kedestin/Junior-Design/Phase 5/pinout.md

# Pin-Outs (Untaped Bot)

## Dashboard

### Seven-Segment

             _______
          F_|        |_A
          G_|        |_B
    cathode_|        |_cathode
            |        |
          E_|        |_DP
          D_|        |_C
            |________|

* f - 51
* g - 50
* e - 49
* d - 47
* a - 53
* b - 52
* dp - No connection
* c - 34

### Misc. Leds

* Red LED - 48
* Green LED - 46
* Blue LED - 44
* Yellow LED - 2

### Horn

* Speaker - 3

## Receiver

* Mic Input - A7

## Transmitter

* PWM Out - 5
* Data Out - 30

## H-Bridge

* Left Rear - 8
* Left Forward - 10
* Right Rear - 11
* Right Forward - 9

## Sensor Board

### Color Sensor

* Red LED - 36
* Blue LED - 37
* Photodiode - A15

### Proximity Sensor

* Photodiode - A5

### Hall Sensor

* Output - 39

## Indicator Lights

### Front-Left

* White LED - 45

### Front-Right

* White LED - 38

### Back-Left

* Red LED - 25
* Yellow LED - 27

### Back-Right

* Red LED - 24
* Yellow LED - 26

## Bumpers 

### Front-Left 

* Limit Switch - 43

### Front-Right

* Limit Switch - 42

### Back

* Limit Switch - 28

## Bot 1 vs. Bot 2

* Signal - 33
