kedestin/Junior-Design/Erythraean/Status Report Slides.pptx

## Week One Status

- Completed Pre Studio 1A
- Working on Design
- Need Pre Studio 1B and Design 1B done for Thursday, then onto 2.
- Team building – yay!

## Week Two Status Report

- Completed Phase 1A on Thursday 1/24
- Completed Phase 1B on Saturday 1/26
- We are on track with our schedule
- Phase 2A to be started in Monday meeting
- Target Demo Date for 2A TBD
- Teamwork is good so far
- Everything is taking longer than expected - we’re doing too much or we’re underestimating?

## Week Three Status Report

- Completed Phase 2A even with delay (Kelsey sick)
- Began work on Phase 2B.
- Burned ~5 MoSfEtS
- Have a functional MOSFET H-Bridge
- Teamwork and communication good (Kelsey upset with this description – how’s that for teamwork and communication huh)
- Ron, if you’re reading this, blink twice.
- Gotcha.

## Week Four Status Report

- Completed Phase 2B on Tuesday
- Began work on Phase 3A on Thursday
- Next week continuing work on 3A, will decide due date soon
- Have a small fixture to test photodiode – more work required
- Code for sensing needs to be done
- Integrating motion and sensors potentially by end of week

## Week Five Status Report

- Everything for Design 3A is complete
- Demo’ing on Tuesday (2/19)
- Collision Detection Spec will be started next week
- 2/14 Talked to Client/Contractor about phase 3B
- Team Morale still high
- Crushing it.

## Week Six Status Report

- Demo’d Design 3A on Tuesday 2/19
- Worked on Collision Detection Spec to give to Team Corbeau 2/21
- Have final document to hand to Corbeau
- Signed Griege spec 2/19
- Worked on improving color detection and searching
- Started futzing with limit switches – have working circuit
- Team morale: still good.
- Still crushing it.
