kedestin/Junior-Design/Erythraean/BatMobile_2B.jpeg

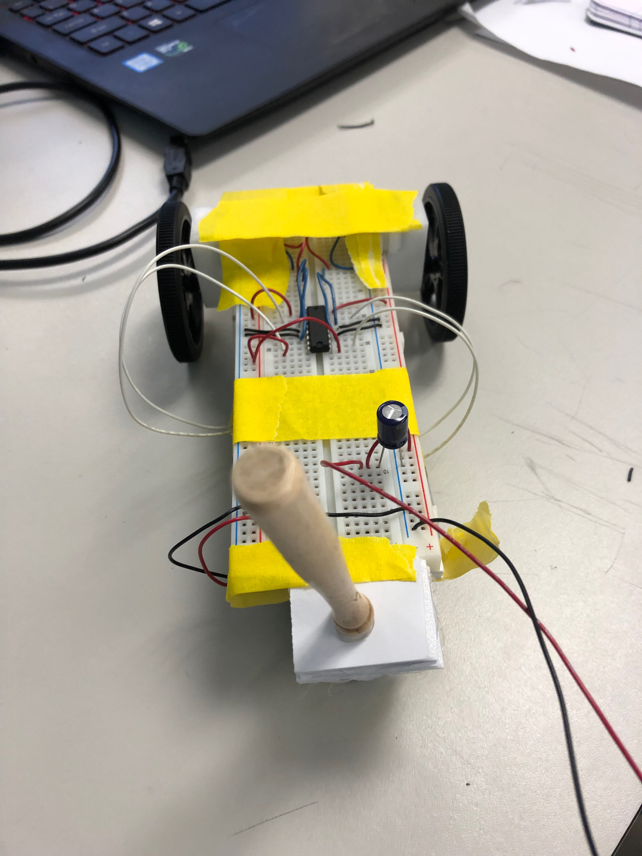
Erythraean/BatMobile_2B.jpeg
