kedestin/Junior-Design/Erythraean/Circuit_01A.jpeg

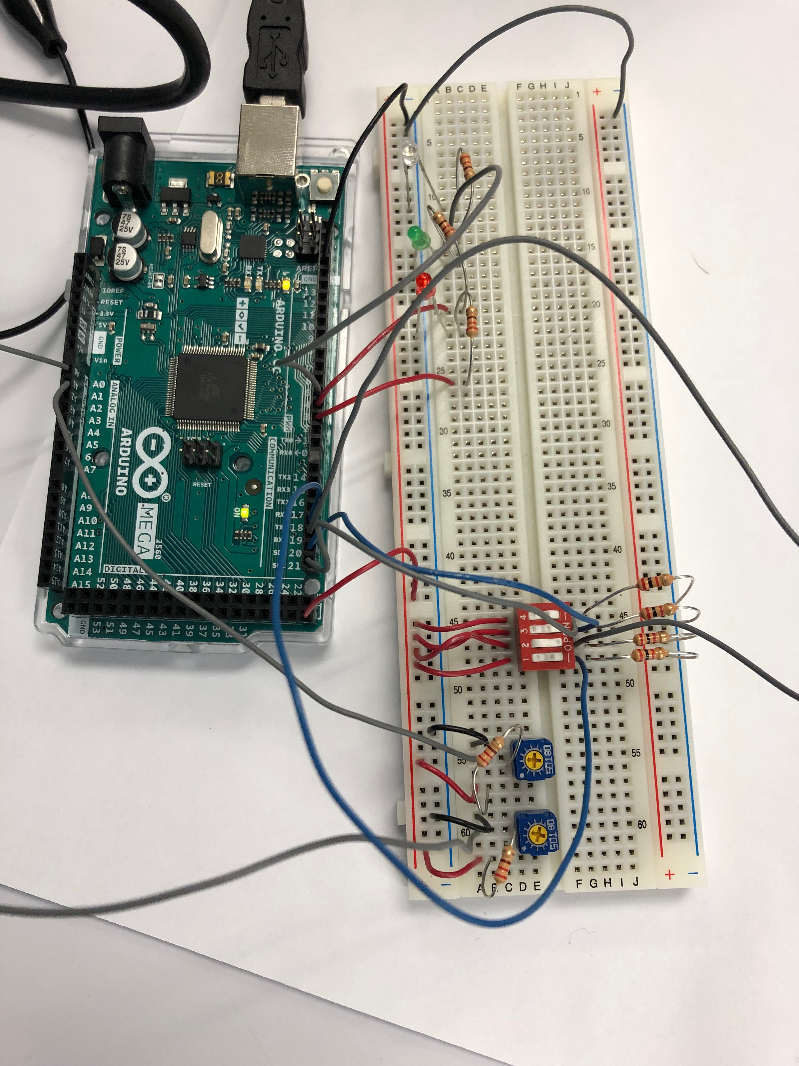
Erythraean/Circuit_01A.jpeg
