kedestin/Junior-Design/Erythraean/Circuit_2A.jpeg

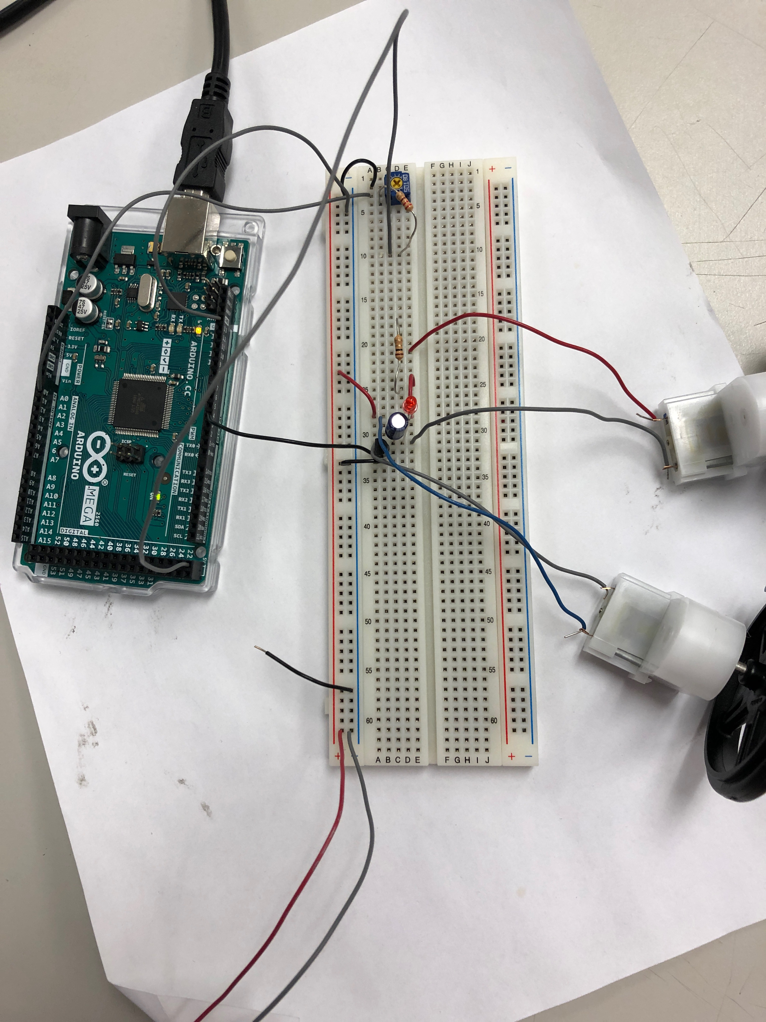
Erythraean/Circuit_2A.jpeg
