kedestin/Junior-Design/Erythraean/Circuit_2A_FETHbridge.jpeg

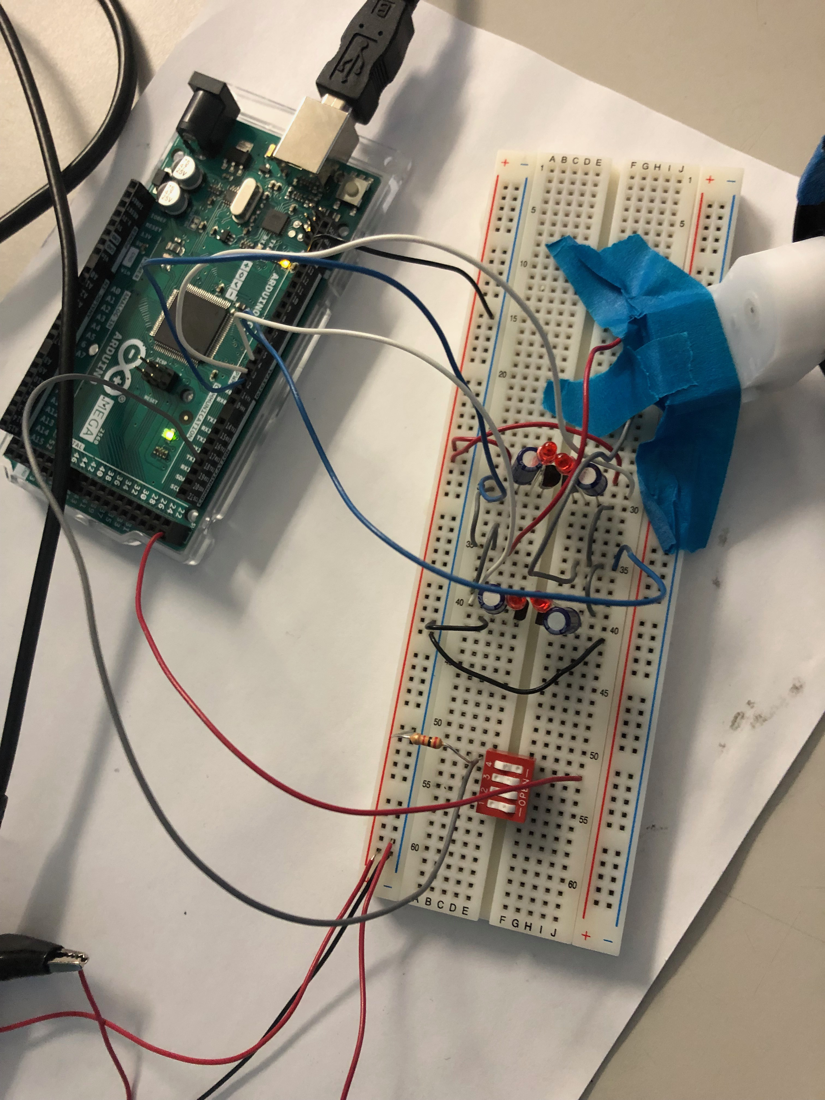
Erythraean/Circuit_2A_FETHbridge.jpeg
