kedestin/Junior-Design/Erythraean/Circuit_2B.jpeg

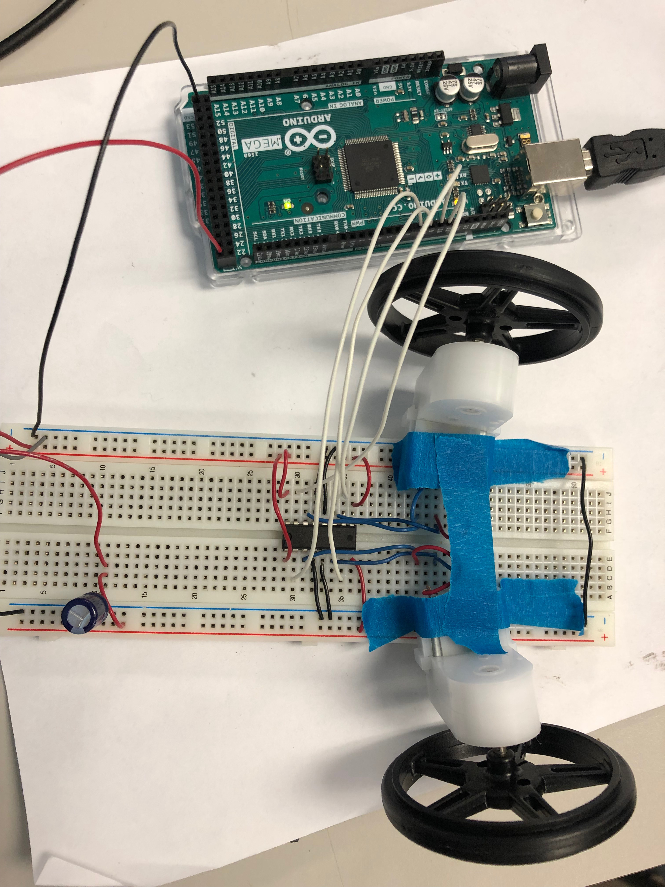
Erythraean/Circuit_2B.jpeg
