kedestin/Junior-Design/Erythraean/Circuit_HallEffect.jpeg

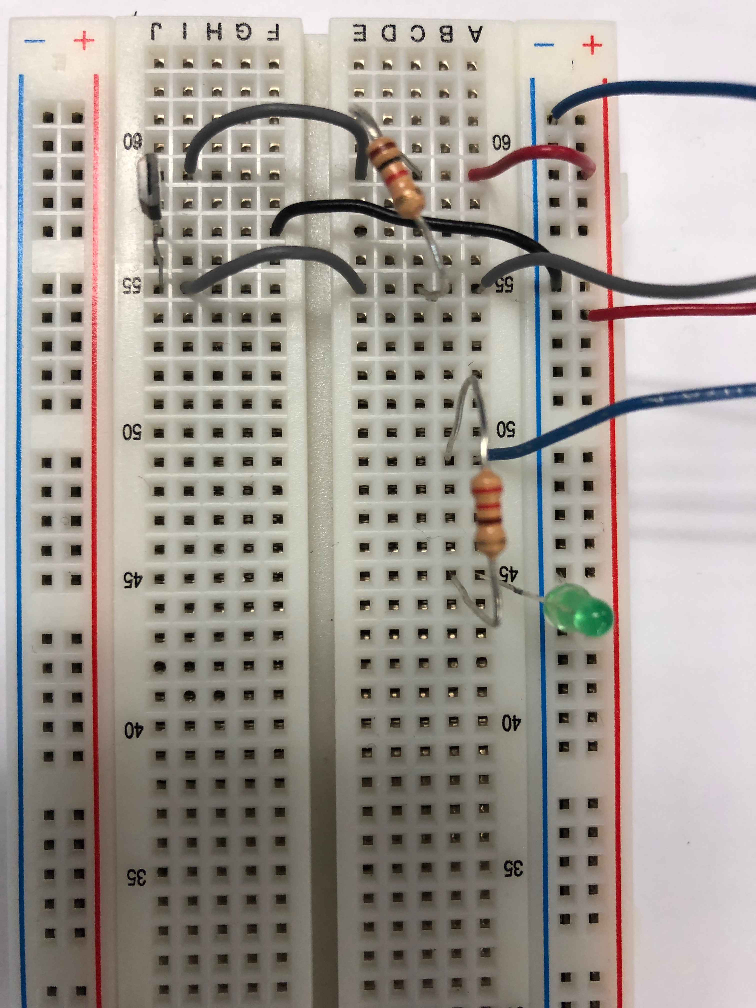
Erythraean/Circuit_HallEffect.jpeg
