kedestin/Junior-Design/Erythraean/FrontBumper.png

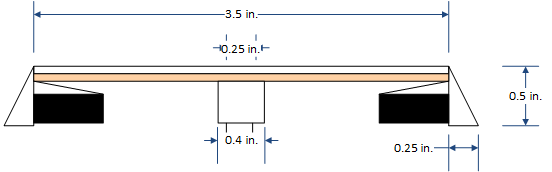
Erythraean/FrontBumper.png
