kedestin/Junior-Design/Erythraean/FrontBumper_Front.png

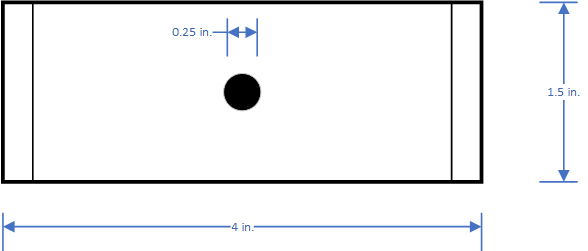
Erythraean/FrontBumper_Front.png
