kedestin/Junior-Design/Erythraean/FrontBumper_Rear.png

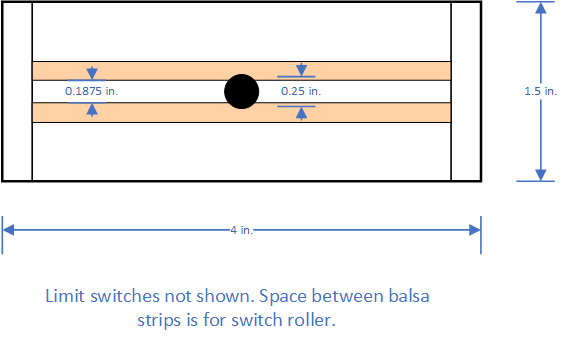
Erythraean/FrontBumper_Rear.png
