kedestin/Junior-Design/Erythraean/RearBumper_Top.png

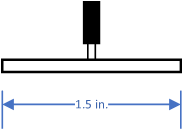
Erythraean/RearBumper_Top.png
