kedestin/Junior-Design/Erythraean/ZoomedCircuit_01A.jpeg

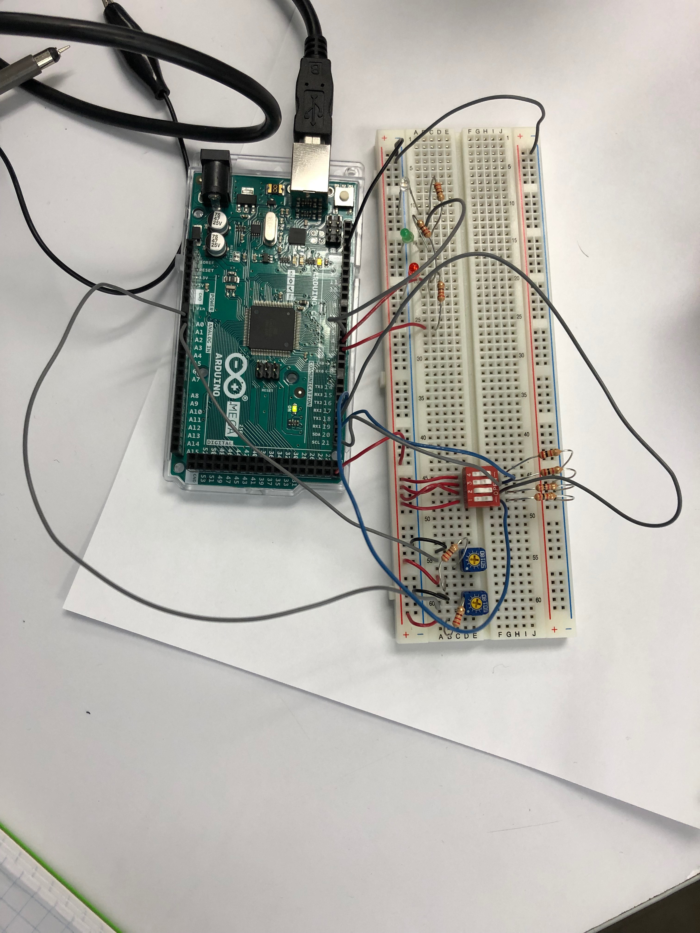
Erythraean/ZoomedCircuit_01A.jpeg
