kedestin/Junior-Design/Phase 2/Design Phase - 2B/demo/HBridge_schematic.png

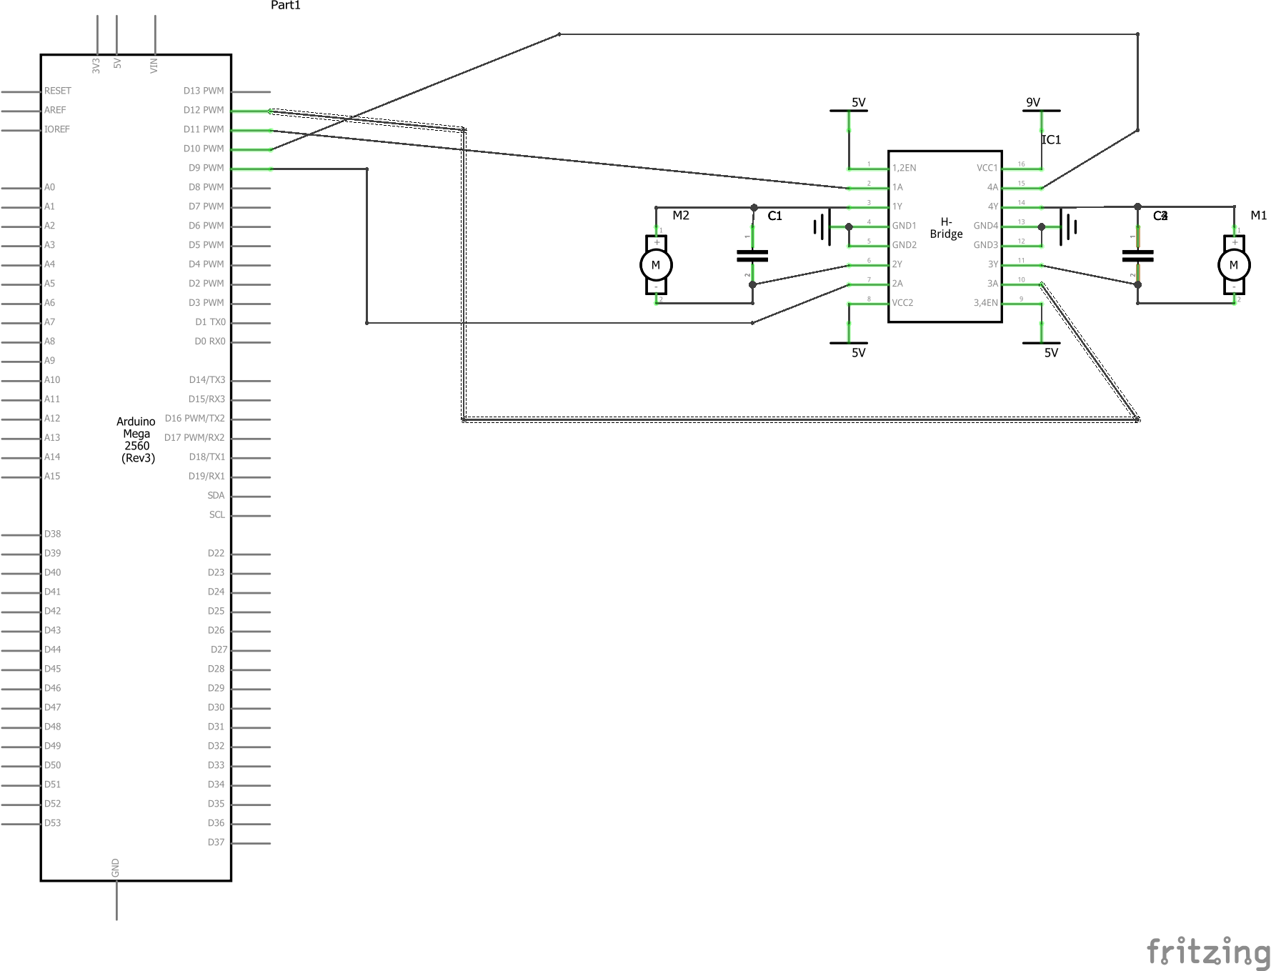
Phase 2/Design Phase - 2B/demo/HBridge_schematic.png
