kedestin/Junior-Design/Phase 4/Phase4BlockDiagram.jpg

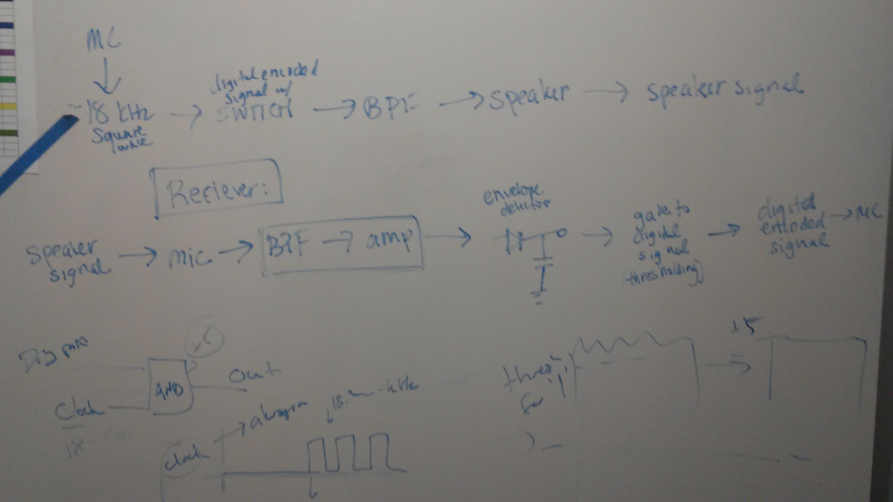
Phase 4/Phase4BlockDiagram.jpg
