kedestin/Junior-Design/Phase 5/collision_detection_bb.png

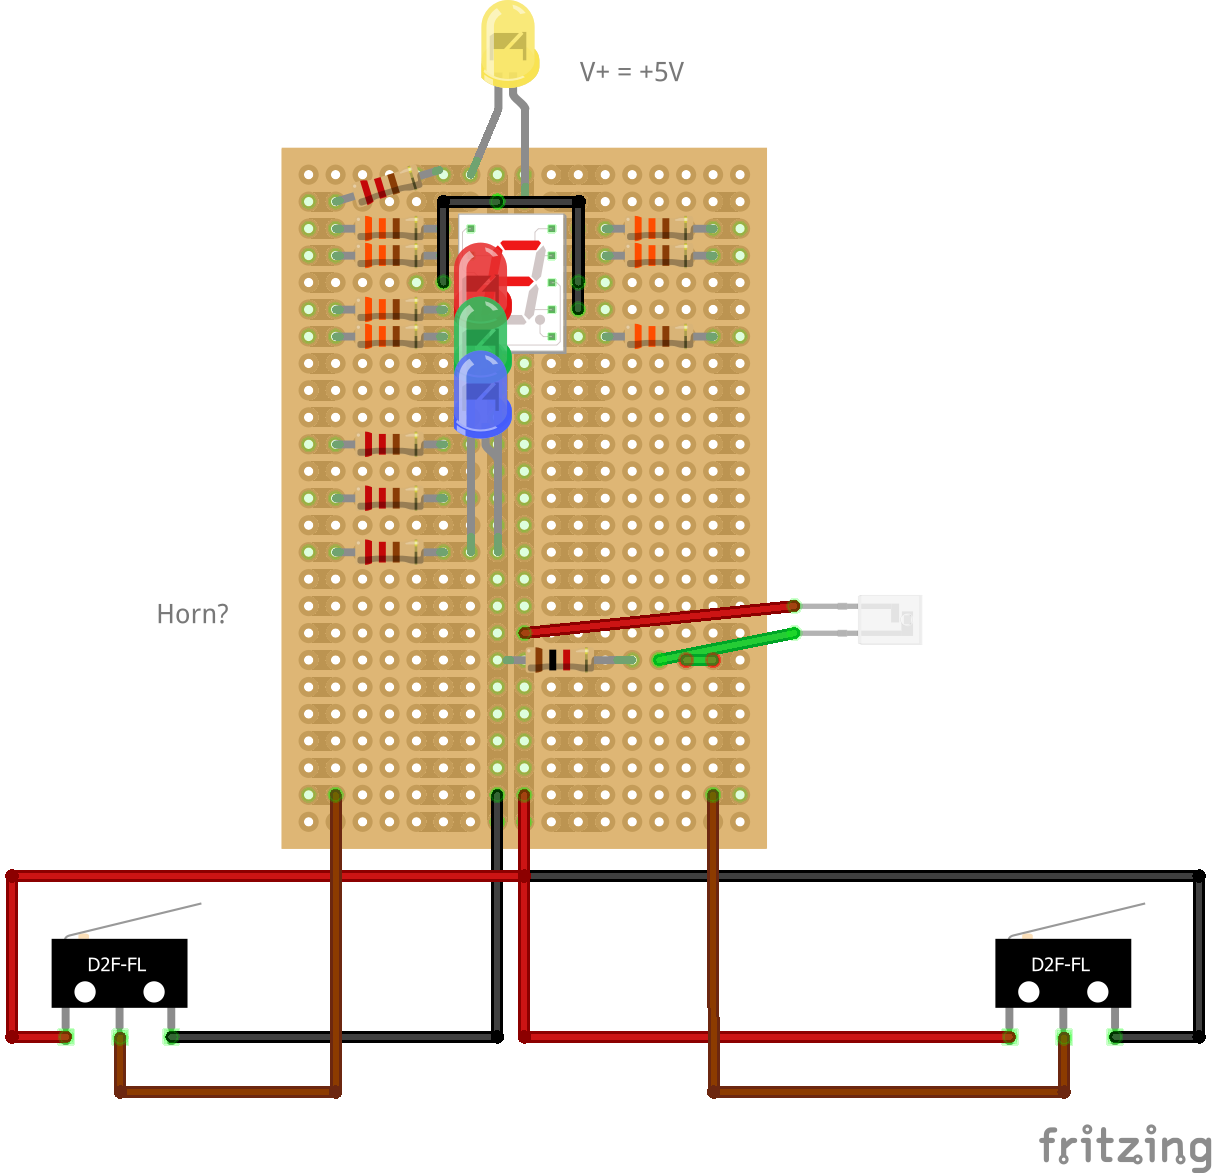
Phase 5/collision_detection_bb.png
