kedestin/Junior-Design/Phase 5/headlights_bb.png

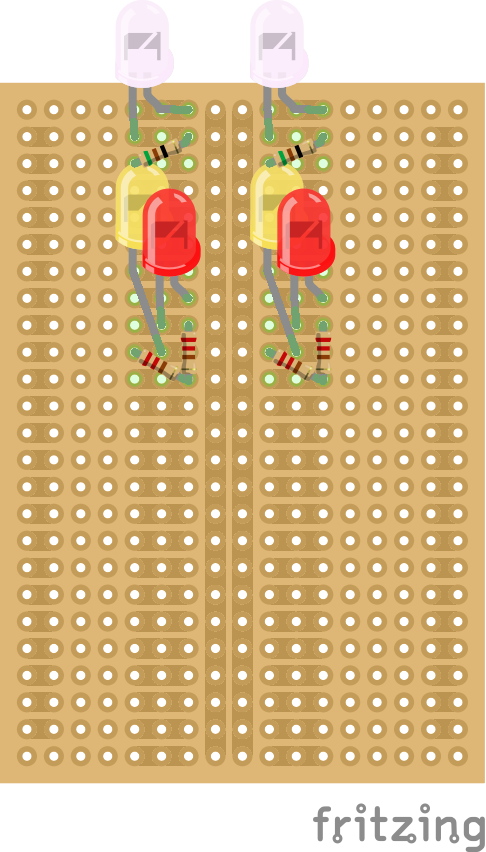
Phase 5/headlights_bb.png
