kedestin/Junior-Design/Phase 5/receiver_bb.png

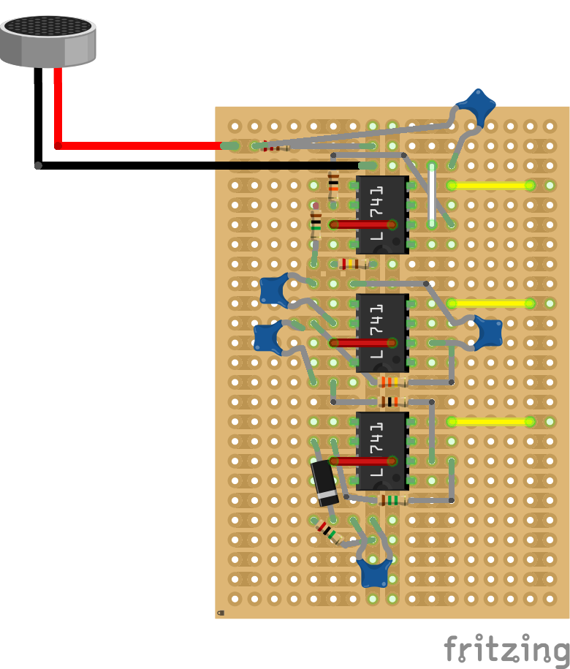
Phase 5/receiver_bb.png
