kedestin/Junior-Design/Phase 5/sensor_board_bb.png

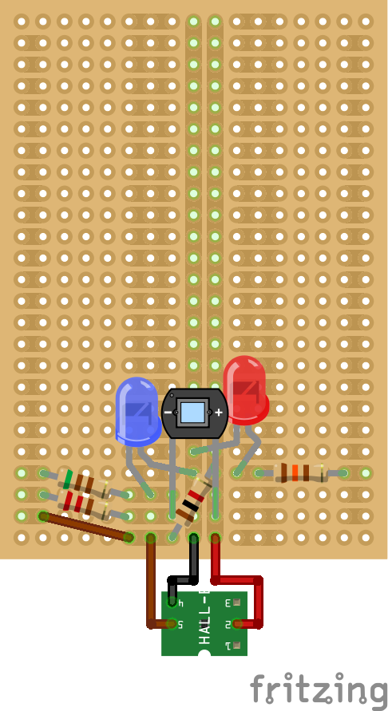
Phase 5/sensor_board_bb.png
