kedestin/Junior-Design/Phase 5/transmitter_bb.png

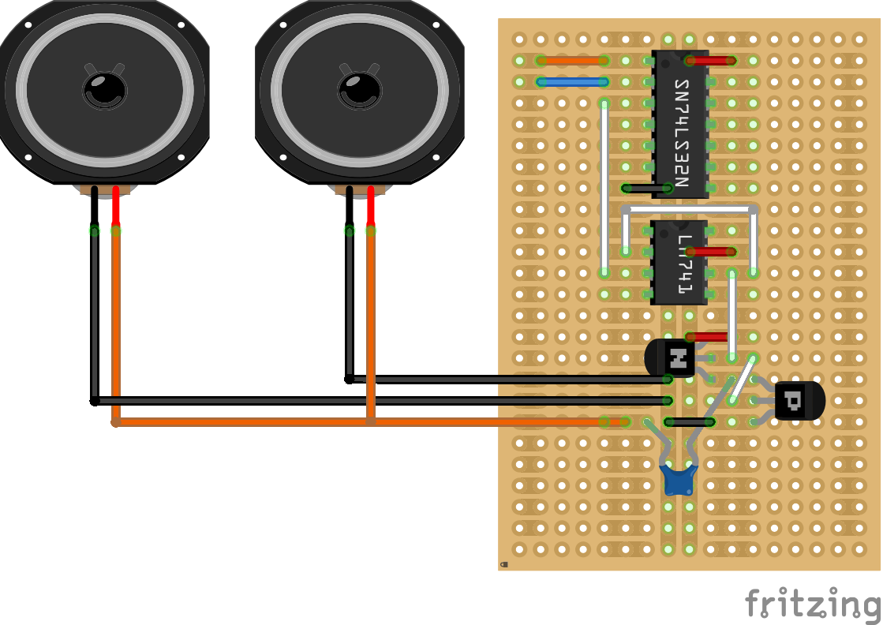
Phase 5/transmitter_bb.png
