kedestin/Junior-Design/Phase 5/voltage_regulator_and_hbridge_bb.png

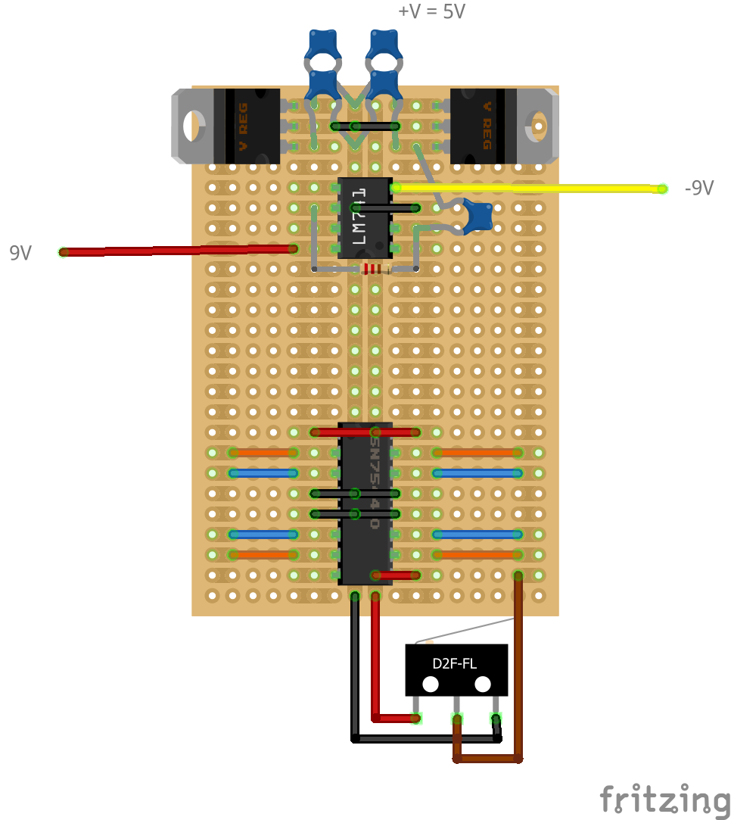
Phase 5/voltage_regulator_and_hbridge_bb.png
