kedestin/Junior-Design/Erythraean/CostAnalysis.xlsx

Sheet: Item Cost
Item | Cost Per Unit | Number of Units | Total Cost
Blue LED | 0.3 | 3 | 0.9 | 232.455
Red LED | 0.3 | 8 | 2.4
Green LED | 0.3 | 3 | 0.9
Dip Switch | 0.5 | 1 | 0.5
Arduino Mega 2560 | 38.5 | 1 | 38.5
220 Ohm Resistor | 0.15 | 5 | 0.75
500 Ohm Potentiometer | 1 | 1 | 1
H-Bridge | 2.95 | 2 | 5.9
Foam Core | 0.003 | 75 | 0.225
100 uF Capacitor | 0.09 | 1 | 0.09
10 uF Capacitor | 0.15 | 4 | 0.6
BS170 NMOS Transistor | 0.17 | 6 | 1.02
BS250 PMOS Transistor | 0.75 | 4 | 3
Wire | 0.105 | 10 | 1.05
5.1 kOhm resistor | 0.3 | 1 | 0.3
1 kOhm resistor | 0.3 | 1 | 0.3
Hall effect sensor | 2.5 | 2 | 5
Photodode | 1.11 | 4 | 4.44
Limit switch | 1.5 | 6 | 9
741 op amp | 0.6 | 5 | 3
Yellow LED | 0.3 | 3 | 0.9
resistors | 0.2 | 34 | 6.8
capacitors | 0.1 | 11 | 1.1
2N3904 npn transistor | 0.42 | 1 | 0.42
2N3906 pnp transistor | 0.42 | 1 | 0.42
balsa wood | 1.5 | 1 | 1.5
cls0201ma Speaker | 3.87 | 2 | 7.74
SP-1504 Speaker | 1.87 | 1 | 1.87
CMA-4544PF Microphone | 0.65 | 1 | 0.65
AND gate | 0.51 | 1 | 0.51
ln914 fs Diode | 0.16 | 1 | 0.16
7 segment display | 0.85 | 1 | 0.85
dpdt mini switch | 2.5 | 1 | 2.5
bolts | 0.25 | 6 | 1.5
1067 Machine Hex Nut | 0.89 | 10 | 8.9
Mini Plastic Gearmotor | 5.49 | 2 | 10.98
Kester 44 Rosin Core Solder | 21.83 | 1 | 21.83
16 pin dip ic pc socket | 3 | 1.5 | 4.5
aluminum sheet metal | 3.5 | 1 | 3.5
male headers | 0.1 | 50 | 5
Breadboard jumper | 0.1 | 40 | 4
Duracell 9 V battery | 2.49 | 4 | 9.96
1.5 V batteries | 2.1 | 4 | 8.4
heat shrink | 1.5 | 1 | 1.5
electrical tape | 3.5 | 1 | 3.5
wheels | 7.95 | 1 | 7.95
protoboards | 3.16 | 6 | 18.96
solder wick | 4.3 | 1 | 4.3
LM78XX Votage Regulator | 1.19 | 2 | 2.38
8 pin dip ic pc socket | 1.5 | 4 | 6
Pololu Ball Caster (1") | 5 | 1 | 5
Total Materials Cost |  |  | 232.455

Sheet: Labor Cost
Person | Cost per Hour | Hours Worked | Total Cost
Engineer | 42.19 | 202 | 8522.38
Manufacturing Worker | 26.31 | 74 | 1946.94
Project Manager | 66.11 | 58 | 3834.38
Total Labor Costs |  |  | 14303.7

Sheet: Kelsey's Hours
Phase | Engineer | Manufacturing Worker | Project Manager | Total Engineer Hours | 99
1 | 10 | 0 | 17 | Total Manufacturing Worker Hours | 39
2 | 13 | 1 | 2 | Total Project Manager Hours | 33
3 | 19 | 0 | 5
4 | 33 | 0 | 4
5 | 24 | 38 | 5

Sheet: Ben's Hours
Phase | Engineer | Manufacturing Worker | Project Manager | Total Engineer Hours | 103
1 | 10 | 0 | 9 | Total Manufacturing Worker | 35
2 | 13 | 1 | 2 | Total Project Manager | 25
3 | 19 | 0 | 5
4 | 33 | 0 | 4
5 | 28 | 34 | 5
