kedestin/Junior-Design/(list of files, drawings)

Other design files:
Phase 1/Schematic.fzz
Phase 2/Design Phase - 2B/demo/HBridge.fzz
Phase 3/Design Phase - 3A/Color Sensor.fzz
Phase 3/Design Phase - 3A/Hall Sensor.fzz
Phase 5/collision_detection.fzz
Phase 5/headlights.fzz
Phase 5/receiver.fzz
Phase 5/transmitter.fzz
Phase 5/voltage_regulator_and_hbridge.fzz
