kedestin/Junior-Design/FinalDemo/Challenge5/src/Switch.h

#ifndef JD_SWITCH_H
#define JD_SWITCH_H

#include "Peripheral.h"

namespace JD {

/**
 * @brief An abstraction for a switch
 *
 * @tparam numPins
 */
template <unsigned numPins>
class Switch : public Peripheral<numPins> {
private:
        using Peripheral<numPins>::m_pin;
        uint32_t val = 0;

public:
        static_assert(numPins <= 32, "Only supports 0 to 32 pins");

        template <class... T>
        constexpr Switch(T... args) : Peripheral<numPins>(args...), val(0) {
                static_assert(sizeof...(args) == numPins,
                              "Number of constructor arguments must match "
                              "number of pins\n");
        }

        void update() override {
                val = 0;
                for (unsigned i = 0; i < sizeof(m_pin) / sizeof(m_pin[0]); i++)
                        val &= digitalRead(m_pin[0]) << i;
        }


        uint32_t read() { return val; }
};

template <>
void Switch<1>::update() {
        val = digitalRead(m_pin);
}
}  // namespace JD

#endif
