kedestin/Junior-Design/(commit log)

2019-02-05 Motor Callibration + OOD Motor code
2019-02-06 Motor Testing
2019-02-15 Refactor Sensor/Led Interface
2019-02-26 Add configuration code + macros
    [Schematic.fzz]
2019-02-26 Erythraean Resources Added
    [CostAnalysis.xlsx]
2019-03-09 Executive Summary 3
    [Color Sensor.fzz, HBridge.fzz, Hall Sensor.fzz]
2019-03-16 Timer.h, Protothread.h, Documentation
2019-03-26 REMEMBER TO SET OUTPUT PIN MODE + Demo'd Phase 4
2019-04-02 Collision + Sensor layout
    [collision_detection.fzz, sensor_board.fzz]
2019-04-02 receiver layout
    [receiver.fzz]
2019-04-02 Smaller Resistors
    [receiver.fzz]
2019-04-02 Layouts almost done, missing -5 on op amps
    [collision_detection.fzz, receiver.fzz, sensor_board.fzz, transmitter.fzz, voltage_regulator_and_hbridge.fzz]
2019-04-16 Updated challenges + Some testing on Bot
    [HBridge.fzz, sensor_board.fzz]
2019-04-19 Go Beyond Arduino Code Start
2019-04-19 Update Pin Map
    Pin Map to Ardiuno for both bots
2019-04-23 Timer has elapsed'
